ifilot/c64-megacart/pcb/c64-megacart.kicad_pcb

## KiCad design pcb/c64-megacart.kicad_pcb (2024-09-02)

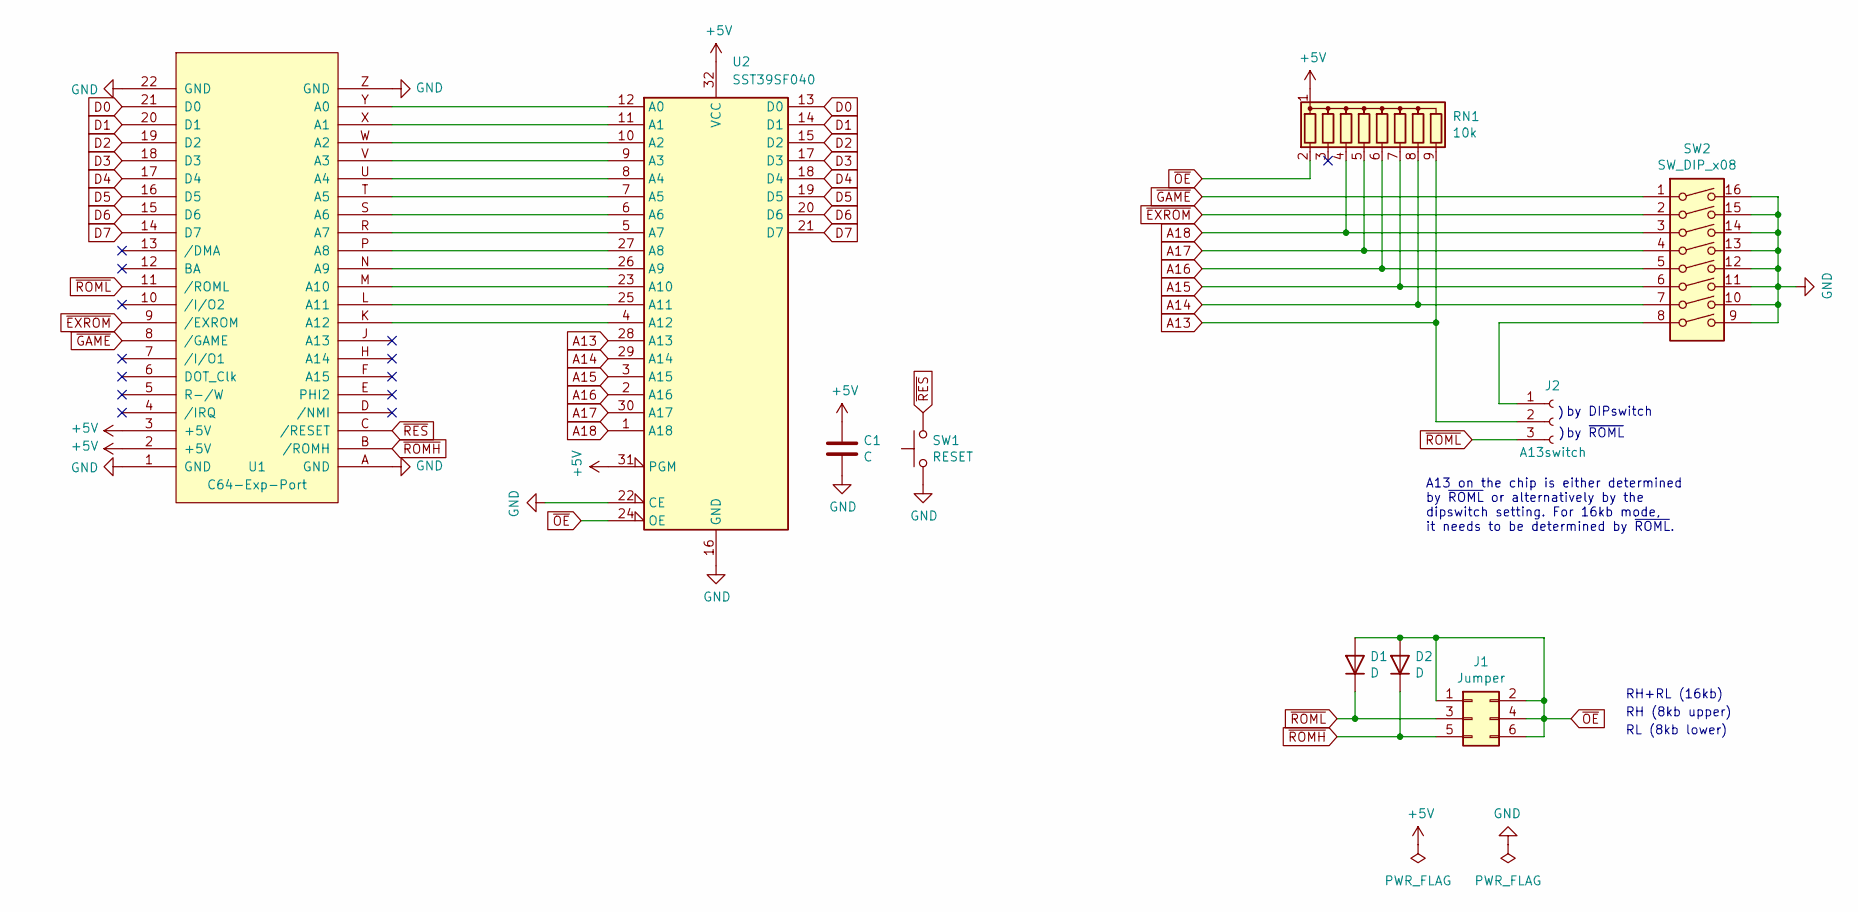
[picture p1: schematic c64-megacart.kicad_sch, C64 MegaCartridge]

Parts:
C1: C; C_Disc_D5.0mm_W2.5mm_P5.00mm
D1, D2: D; D_DO-35_SOD27_P7.62mm_Horizontal
J1: Jumper; PinHeader_2x03_P2.54mm_Vertical
J2: A13switch; PinHeader_1x03_P2.54mm_Vertical
RN1: 10k; R_Array_SIP9
SW1: RESET; SW_PUSH_6mm
SW2: SW_DIP_x08; SW_DIP_SPSTx08_Slide_9.78x22.5mm_W7.62mm_P2.54mm
U1: C64-Exp-Port; C64-Cart
U2: SST39SF040

Connections:
+5V: C1.1, RN1.1 (common), U1.2 (+5V), U1.3 (+5V), U2.31 (PGM), U2.32 (VCC)
A13: J2.2, RN1.9 (R8), U2.28 (A13)
A14: RN1.8 (R7), SW2.7, U2.29 (A14)
A15: RN1.7 (R6), SW2.6, U2.3 (A15)
A16: RN1.6 (R5), SW2.5, U2.2 (A16)
A17: RN1.5 (R4), SW2.4, U2.30 (A17)
A18: RN1.4 (R3), SW2.3, U2.1 (A18)
D0: U1.21 (D0), U2.13 (D0)
D1: U1.20 (D1), U2.14 (D1)
D2: U1.19 (D2), U2.15 (D2)
D3: U1.18 (D3), U2.17 (D3)
D4: U1.17 (D4), U2.18 (D4)
D5: U1.16 (D5), U2.19 (D5)
D6: U1.15 (D6), U2.20 (D6)
D7: U1.14 (D7), U2.21 (D7)
GND: C1.2, SW1.1, SW2.9, SW2.10, SW2.11, SW2.12, SW2.13, SW2.14, SW2.15, SW2.16, U1.1 (GND), U1.22 (GND), U1.A (GND), U1.Z (GND), U2.16 (GND), U2.22 (CE)
unnamed: J2.1, SW2.8
unnamed: U1.K (A12), U2.4 (A12)
unnamed: U1.L (A11), U2.25 (A11)
unnamed: U1.M (A10), U2.23 (A10)
unnamed: U1.N (A9), U2.26 (A9)
unnamed: U1.P (A8), U2.27 (A8)
unnamed: U1.R (A7), U2.5 (A7)
unnamed: U1.S (A6), U2.6 (A6)
unnamed: U1.T (A5), U2.7 (A5)
unnamed: U1.U (A4), U2.8 (A4)
unnamed: U1.V (A3), U2.9 (A3)
unnamed: U1.W (A2), U2.10 (A2)
unnamed: U1.X (A1), U2.11 (A1)
unnamed: U1.Y (A0), U2.12 (A0)
~EXROM: SW2.2, U1.9 (/EXROM)
~GAME: SW2.1, U1.8 (/GAME)
~OE: D1.2 (A), D2.2 (A), J1.1, J1.2, J1.4, J1.6, RN1.2 (R1), U2.24 (OE)
~RES: SW1.2, U1.C (/RESET)
~ROMH: D2.1 (K), J1.5, U1.B (/ROMH)
~ROML: D1.1 (K), J1.3, J2.3, U1.11 (/ROML)

Notes on the sheet:
by ~{ROML}
RH (8kb upper)
RL (8kb lower)
A13 on the chip is either determined by ~{ROML} or alternatively by the dipswitch setting. For 16kb mode, it needs to be determined by ~{ROML}.
by DIPswitch
RH+RL (16kb)

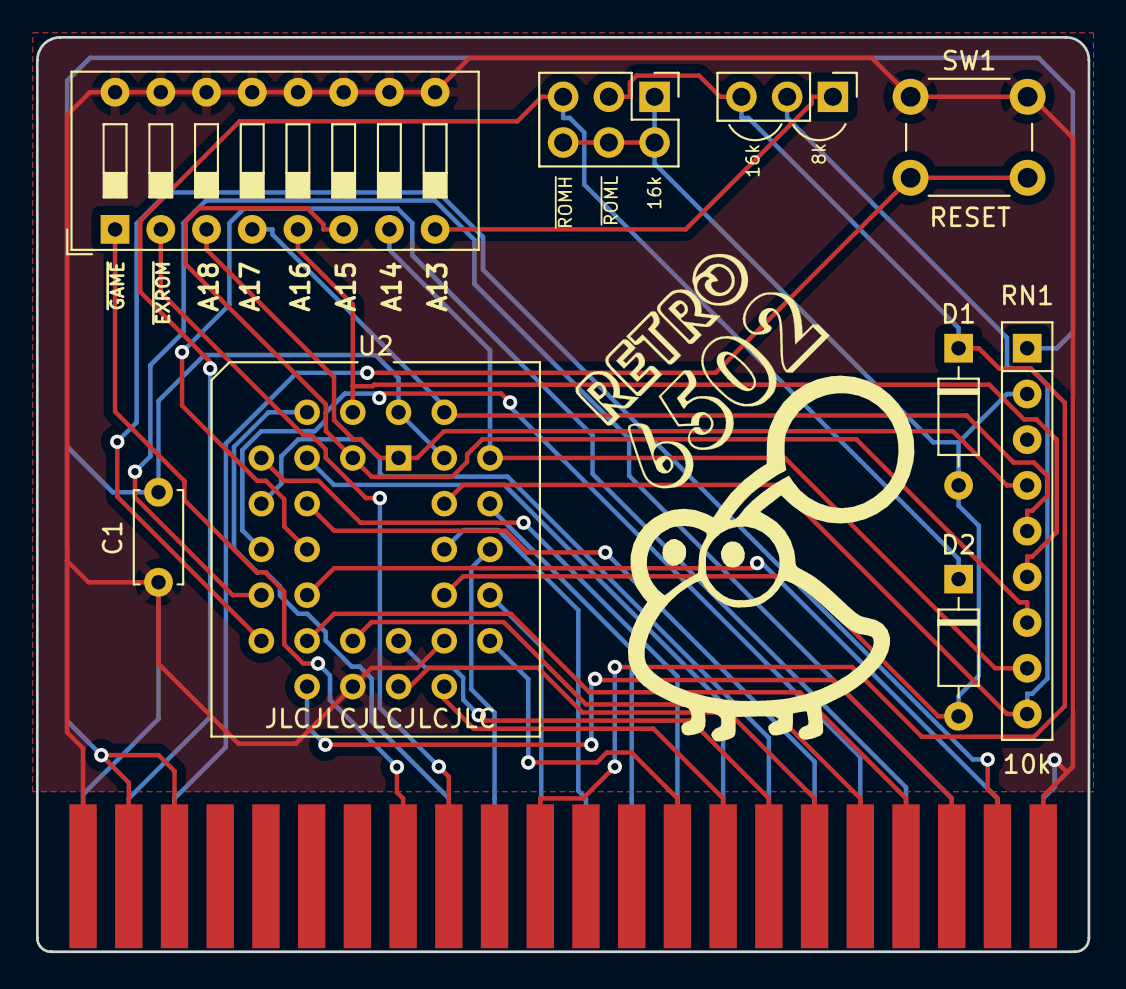
[picture p2: board c64-megacart.kicad_pcb from above]

Board: 2 copper layers, 58.4 x 50.8 mm, 11 parts (0 on the bottom side), 36 nets.

Other parts of the board:
G001: LOGO; puni
